supine0703/c51_treg/docs/图 from zyy/说明.txt

本文件内的流程图包含了系统使用流程图，
以及ultimate.c内我认为比较重要的一些方法具体实现的流程图
（按键系统，lcd开机动画，一个页面显示）
