supine0703/c51_treg/docs/图 from yym/主函数.jpg

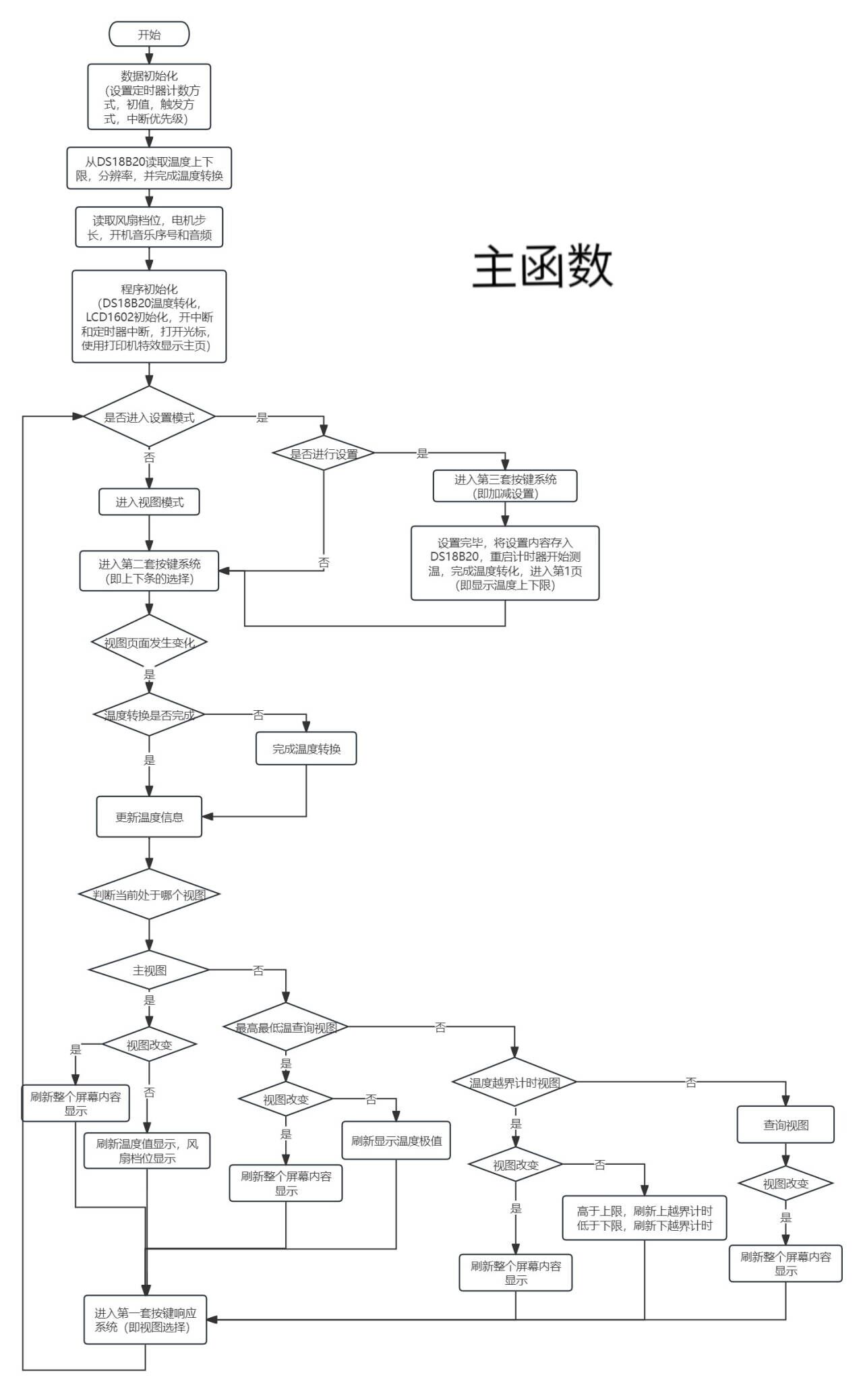
docs/图 from yym/主函数.jpg
