supine0703/c51_treg/docs/图 from zyy/模块依赖图.png

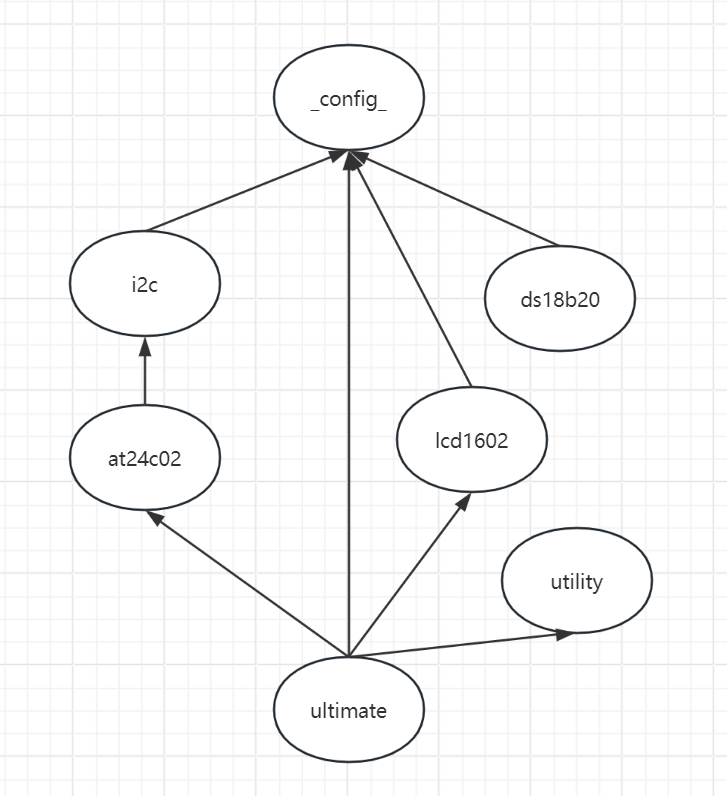
docs/图 from zyy/模块依赖图.png
