supine0703/c51_treg/(list of files, cad)

Other CAD files:
proj/proj_keil5_music/Objects/main.obj
proj/proj_keil5/Objects/main.obj
proj/proj_keil5/Objects/at24c02.obj
proj/proj_keil5/Objects/lcd1602.obj
proj/proj_keil5_music/Objects/music.obj
proj/proj_keil5/Objects/STARTUP.obj
proj/proj_keil5_music/Objects/i2c.obj
proj/proj_keil5/Objects/global.obj
proj/proj_keil5_music/Objects/STARTUP.obj
proj/proj_keil5/Objects/ultimate.obj
proj/proj_keil5_music/Objects/at24c02.obj
proj/proj_keil5/Objects/i2c.obj
proj/proj_keil5/Objects/utility.obj
proj/proj_keil5/Objects/ds18b20.obj
proj/proj_keil5/Objects/__config__.obj
