supine0703/c51_treg/(list of files, drawings)

Other design files:
proj/proj_proteus8.6/Ultimate2.pdsprj
proj/proj_proteus8.6/Ultimate.pdsprj
