supine0703/c51_treg/proj/src/ultimate.c

/**
 * 作者：李宗霖 日期：2023/12/01
 * CSDN昵称：Leisure_水中鱼
 * CSDN: https://blog.csdn.net/Supine_0?type=blog
 * ----------------------------------------------
 */
#include "__config__.h"
#include "at24c02.h"
#include "lcd1602.h"
#include "utility.h"

#define uint unsigned int
#define uchar unsigned char

#define WELCOME "Welcome to AAUCS"
#define _GROUP_ "      NO.13     "
#define SETTING_NUM 6

extern uint SHOW_WAIT;
extern bit page_change;
extern bit ringtone_change;
extern char upperLimit, lowerLimit;
extern float temperature;
extern float highest, lowest;
extern uchar fanGear, fanGearStep;
extern uchar hus, hms, hs, hm; // 开机后 超过温度上限 时间
extern uchar lus, lms, ls, lm; // 开机后 低于温度下限 时间
extern uchar key, pressKey, page, option;
extern uchar dsr, ringtoneNum, ringRate, changeCount;
extern uchar numStr[];
extern uchar code DC[];
extern uchar idata musicArr[];

void Delay1ms(uint t) // 12MHz
{                     // 软件延迟 参数用uchar 比uint 精准
    uchar i;
    while (t--) // mov dec mov jnz orl jz : 9us
    {
        i = 123;    // mov : 1us
        while (i--) // mov dec mov jz : 6us * 124
        {
        } // jmp : 2us * 123
    }     // 每当低位为 0 会多1us处理高位(dec) 忽略
} // (8+1+8*124-2)us * t + ((t/256)+10+6)us 约 t ms

void UpdateExtremes(bit which);

// ============== LCD1602 ==============

void LCD1602_ShowString(uchar* s)
{
    while (*s)
    {
        LCD1602_WriteData(*s++);
        Delay1ms(SHOW_WAIT);
    }
}

void LCD1602_Action(void)
{
    uchar i;
    // 开启 LCD1602 显示 (initial)
    LCD1602_WriteCmd(Set_8bit_2line_5x7);   // 命令6
    LCD1602_WriteCmd(Show_CursorOff);       // 命令4
    LCD1602_WriteCmd(Mode_CursorRightMove); // 命令3
    LCD1602_WriteCmd(Clear_Screen);         // 命令1

    // 开机界面
    LCD1602_WriteCmd(Move_Cursor_Row1_Col(16)); // 命令8 设置光标在显示屏之外
    LCD1602_ShowString(WELCOME);
    SHOW_WAIT = 200;
    LCD1602_WriteCmd(Move_Cursor_Row2_Col(16)); // 命令8
    LCD1602_WriteCmd(Mode_ScreenRightMove);     // 命令3
    LCD1602_ShowString(_GROUP_); // 一边输出第二行 一边移动屏幕
    LCD1602_WriteCmd(Mode_CursorRightMove); // 命令3  恢复光标自增

    i = 3;
    do // 闪烁三次
    {
        LCD1602_WriteCmd(Show_ScreenOff); // 命令4
        Delay1ms(SHOW_WAIT * 2);
        LCD1602_WriteCmd(Show_CursorOff); // 命令4
        Delay1ms(SHOW_WAIT * 2);
    } while (--i);
    i = 16;
    do
    {
        LCD1602_WriteCmd(Shift_ScreenRight); // 命令5
        Delay1ms(SHOW_WAIT);
    } while (--i);                  // 字体移出屏幕
    LCD1602_WriteCmd(Clear_Screen); // 命令1 清屏
    SHOW_WAIT = 0;
} // LCD1602 Action

void ShowViewPage_1(void)
{
    // 第一行 温度上限 温度下限
    LCD1602_WriteCmd(Clear_Screen); // 命令1 清屏
    LCD1602_ShowString("H:");
    Int8ToString(upperLimit, numStr, 3);
    LCD1602_ShowString(numStr);
    LCD1602_ShowString(DC);
    LCD1602_ShowString("  L:");
    Int8ToString(lowerLimit, numStr, 3);
    LCD1602_ShowString(numStr);
    LCD1602_ShowString(DC);
    // 第二行 温度 风扇档位
    LCD1602_WriteCmd(Move_Cursor_Row2_Col(0));
    LCD1602_ShowString("T:");
    FloatToString(temperature, numStr, 5, 1);
    LCD1602_ShowString(numStr);
    LCD1602_ShowString(DC);
    LCD1602_ShowString("  FAN:");
    Int8ToString(fanGear, numStr, 1);
    LCD1602_ShowString(numStr);
}

void ShowViewPage_2(void)
{
    // 第一行 自开机后的最高温
    LCD1602_WriteCmd(Clear_Screen); // 命令1 清屏
    LCD1602_ShowString("Highest: ");
    UpdateExtremes(1);
    // 第二行 自开机后的最低温
    LCD1602_WriteCmd(Move_Cursor_Row2_Col(0));
    LCD1602_ShowString("Lowest:  ");
    UpdateExtremes(0);
}

void ShowViewPage_3(void)
{
    void UpdateOverLimitTimer(bit which);
    // 第一行 超过温度上限时长
    LCD1602_WriteCmd(Clear_Screen); // 命令1 清屏
    LCD1602_ShowString("Above H:");
    UpdateOverLimitTimer(1);
    // 第二行 低于温度下限时长
    LCD1602_WriteCmd(Move_Cursor_Row2_Col(0));
    LCD1602_ShowString("Below L:");
    UpdateOverLimitTimer(0);
}

void ShowViewPage_4(void)
{
    char KeysSystem_3(void);
    uchar i;
    LCD1602_WriteCmd(Clear_Screen); // 命令1 清屏
    // 第一行 温感分辨率 风扇档位步长 (开机音乐?)
    LCD1602_WriteCmd(Clear_Screen); // 命令1 清屏
    LCD1602_ShowString("TR: ");
    LCD1602_WriteData('0' + dsr);
    LCD1602_ShowString("   FGS: ");
    LCD1602_WriteData('0' + fanGearStep);
    LCD1602_ShowString(DC);
    // 第二行 ring速度
    LCD1602_WriteCmd(Move_Cursor_Row2_Col(0));
    LCD1602_ShowString("ringRate:");
    i = 0;
    while (i < ringRate)
    {
        LCD1602_WriteData(0xff);
        ++i;
    }
}

void ShowSettings(uchar opt)
{
    bit i;
    uchar sgl[2][2] = {{0x7e, 0x7f}, {' ', ' '}};
    if (opt == option)
        return;
    if ((opt >> 1) != (option >> 1))
    {
        LCD1602_WriteCmd(Clear_Screen); // 命令1 清屏
        switch (opt >> 1)
        {
        case 0: {
            // 0 温度上限
            LCD1602_WriteCmd(Move_Cursor_Row1_Col(1));
            LCD1602_ShowString("H Limit: ");
            Int8ToString(upperLimit, numStr, 3);
            LCD1602_ShowString(numStr);
            LCD1602_ShowString(DC);
            // 1 温度下限
            LCD1602_WriteCmd(Move_Cursor_Row2_Col(1));
            LCD1602_ShowString("L Limit: ");
            Int8ToString(lowerLimit, numStr, 3);
            LCD1602_ShowString(numStr);
            LCD1602_ShowString(DC);
            break;
        }
        case 1: {
            // 2 温感分辨率
            LCD1602_WriteCmd(Move_Cursor_Row1_Col(1));
            LCD1602_ShowString("TResolution: ");
            LCD1602_WriteData('0' + dsr);
            // 3 风扇档位步长
            LCD1602_WriteCmd(Move_Cursor_Row2_Col(1));
            LCD1602_ShowString("FGear' Step: ");
            LCD1602_WriteData('0' + fanGearStep);
            break;
        }
        case 2: {
            // 4 开机铃声
            LCD1602_WriteCmd(Move_Cursor_Row1_Col(2));
            LCD1602_ShowString("ringtone:  ");
            LCD1602_WriteData('0' + ringtoneNum);
            // 5 音量
            LCD1602_WriteCmd(Move_Cursor_Row2_Col(2));
            LCD1602_ShowString("ring Rate: ");
            LCD1602_WriteData('0' + ringRate);
            break;
        }
        }
    }
    i = opt & 1;
    LCD1602_WriteCmd(Move_Cursor_Row1_Col(0));
    LCD1602_WriteData(sgl[i][0]);
    LCD1602_WriteCmd(Move_Cursor_Row1_Col(15));
    LCD1602_WriteData(sgl[i][1]);
    i = !i;
    LCD1602_WriteCmd(Move_Cursor_Row2_Col(0));
    LCD1602_WriteData(sgl[i][0]);
    LCD1602_WriteCmd(Move_Cursor_Row2_Col(15));
    LCD1602_WriteData(sgl[i][1]);
    option = opt;
}

void ChangeSetting(void)
{
    char i, j;
    uchar cunt = 24;
    bit flag = 0;
    switch (option)
    {
    case 0: {
    } // 这一段差异性和共性都多，为了节约一点内存，三目运算符 时间换空间
    case 1: { // 这一段逻辑复杂，只用知道是增加/减少上限下限的
        i = option ? lowerLimit : upperLimit;
        while (1)
        {
            if (!--cunt)
            {
                cunt = 24;
                flag = !flag;
            }
            LCD1602_WriteCmd((option ? 0xc0 : 0x80) | 10);
            if (flag)
                LCD1602_ShowString("   ");
            else
            {
                Int8ToString(i, numStr, 3);
                LCD1602_ShowString(numStr);
            }
            switch (KeysSystem_3())
            {
            case 2: {
                if (option)
                    lowerLimit = i;
                else
                    upperLimit = i;
            }
            case -2: { // 可能会因为时序造成空白 所以要
                LCD1602_WriteCmd((option ? 0xc0 : 0x80) | 10);
                Int8ToString(option ? lowerLimit : upperLimit, numStr, 3);
                LCD1602_ShowString(numStr); // 刷新一下数据
                return;
            }
            case -1: {
                if (i > -55 && ((i > lowerLimit + 1) || option))
                    --i;
                break;
            }
            case 1: {
                if (i < 127 && ((i < upperLimit - 1) || !option))
                    ++i;
                break;
            }
            }
        }
    }
    case 5: {
        i = ringRate; // 0 - 7
    }
    case 4: {
        if (option == 4)
            i = ringtoneNum; // 0 - 3
    }
    case 3: {
        if (option == 3)
            i = fanGearStep; // 0 - 7
    }
    case 2: { // 这一部分代码几乎一样，就复用了用来增大/减小选项值
        if (option == 2)
            i = dsr; // 0 - 3
        LCD1602_WriteCmd(
            (option & 1 ? 0xc0 : 0x80) |
            ((option == 5 || option == 4) ? 14 : 15)
        );
        while (1)
        {
            if (!--cunt)
            {
                cunt = 24;
                flag = !flag;
            }
            if (flag)
                j = ' ';
            else
                j = '0' + i;
            LCD1602_WriteCmd(Shift_CursorLeft);
            LCD1602_WriteData(j);
            switch (KeysSystem_3())
            {
            case 2: {
                if (option == 5)
                    ringRate = i;
                else if (option == 4 && ringtoneNum != i)
                {
                    ringtone_change = 1;
                    ringtoneNum = i;
                }
                else if (option == 3)
                    fanGearStep = i;
                else if (option == 2)
                    dsr = i;
            }
            case -2: {
                j = option == 5
                        ? ringRate
                        : (option == 4 ? ringtoneNum
                                       : (option == 3 ? fanGearStep : dsr));
                LCD1602_WriteCmd(Shift_CursorLeft);
                LCD1602_WriteData(j + '0');
                return;
            }
            case -1: {
                if (i > 0)
                    --i;
                break;
            }
            case 1: {
                if (i < 3 + ((option == 3 || option == 5) ? 4 : 0))
                    ++i;
                break;
            }
            }
        }
    }
    }
}

// -------------------------------------

bit CheckKeysInvalid()
{
    uchar old = key;
    Delay1ms(10);
    key = 0x0f;
    key |= KEYS;
    return key != old;
}

void KeysSystem_1(void)
{
    KEYS = 0xff;
    key = 0x0f; // 排除 P33 P32 P31 P30
    key |= KEYS;
    switch (key)
    {
    case 0x7f: // P37
    case 0xbf: // P36
    case 0xdf: // P35
    case 0xef: // P34
        if (page == key || CheckKeysInvalid())
            return;
        pressKey = key;
        break;
    case 0xff: // 松开 上升沿触发
        if (pressKey == 0xff || CheckKeysInvalid())
            return;
        page_change = 1;
        page = pressKey;
    default:
        pressKey = 0xff;
    }
}

void KeysSystem_2(void)
{
    uchar opt;
    KEYS = 0xff;
    key = 0x0f; // 排除 P33 P32 P31 P30
    key |= KEYS;
    switch (key)
    {
    case 0x7f: // P37
    case 0xbf: // P36
    case 0xdf: // P35
    case 0xef: // P34
        if (CheckKeysInvalid())
            return;
        pressKey = key;
        break;
    case 0xff: // 松开 上升沿触发
        if (pressKey == 0xff || CheckKeysInvalid())
            return;
        // 执行按键功能
        switch (pressKey)
        {
        case 0x7f: { // P37 进入设置
            EA = 0;
            pressKey = 0xff;
            ChangeSetting();
            pressKey = 0xff;
            EA = 1;
            return;
        }
        case 0xbf: { // P36 下一条
            opt = option + 1;
            if (opt == SETTING_NUM)
                opt = 0;
            break;
        }
        case 0xdf: { // P35 上一条
            if (!option)
                opt = SETTING_NUM - 1;
            else
                opt = option - 1;
            break;
        }
        case 0xef: { // P34 首条
            opt = 0;
        }
        }
        ShowSettings(opt);
    default:
        pressKey = 0xff;
    }
}

char KeysSystem_3(void)
{
    KEYS = 0xff;
    key = 0x0f; // 排除 P33 P32 P31 P30
    key |= KEYS;
    if (CheckKeysInvalid())
        return 0; // 为了稳定的时序，所以在这里消抖
    switch (key)
    {
    // 低电平触发，长按加快变化
    case 0xbf: // P36 增加
    case 0xdf: // P35 减少
        if (pressKey == key)
        {
            if (!changeCount)
            {
                ++changeCount;
                return key == 0xbf ? 1 : -1;
            }
            if ((++changeCount >= 0x60) && !(changeCount & 0x0f))
                return key == 0xbf ? 1 : -1;
            if (changeCount == 0xff)
                changeCount = 0x5f;
            return 0;
        }
        else
        {
            changeCount = 0;
        }
    // 上升沿触发
    case 0x7f: // P37 取消
    case 0xef: // P34 确定
        pressKey = key;
        break;
    case 0xff: // 松开 上升沿触发
        if (pressKey == 0xff)
            return 0;
        // 执行按键功能
        switch (pressKey)
        {
        case 0x7f: { // P37 取消
            pressKey = 0xff;
            return -2;
        }
        case 0xef: { // P34 确定
            pressKey = 0xff;
            return 2;
        }
        }
    default:
        pressKey = 0xff;
    }
    return 0;
}

void AboveLimitClock(void)
{
    if (++hus == 180)
    {
        hus = 0;
        if (++hms == 20)
        {
            hms = 0;
            if (++hs == 60)
            {
                hs = 0;
                if (++hm == 60)
                {
                    hm = 0;
                }
            }
        }
    }
}

void BelowLimitClock(void)
{
    if (++lus == 180)
    {
        lus = 0;
        if (++lms == 20)
        {
            lms = 0;
            if (++ls == 60)
            {
                ls = 0;
                if (++lm == 60)
                {
                    lm = 0;
                }
            }
        }
    }
}

void UpdateOverLimitTimer(bit which) // 1: Above  0: Below
{
    if (which)
    {
        Int8ToString(hm, numStr, 2);
        Int8ToString(hs, numStr + 3, 2);
    }
    else
    {
        Int8ToString(lm, numStr, 2);
        Int8ToString(ls, numStr + 3, 2);
    }
    LCD1602_ShowString(numStr);
    LCD1602_ShowString("m");
    LCD1602_ShowString(numStr + 3);
    LCD1602_ShowString(".");
    if (which)
        Int8ToString(hms >> 1, numStr, 1);
    else
        Int8ToString(lms >> 1, numStr, 1);
    LCD1602_ShowString(numStr);
    LCD1602_ShowString("s");
}

void UpdateExtremes(bit which) // 1: Highest  0: Lowest
{
    FloatToString(which ? highest : lowest, numStr, 5, 1);
    LCD1602_ShowString(numStr);
    LCD1602_ShowString(DC);
}

void ReadMusic(void)
{
    uchar startAddr, musicLen;
    At24c02_ReadData(0xa0, ringtoneNum + 0x03, &startAddr, 1);
    At24c02_ReadData(0xa0, ringtoneNum + 0x04, &musicLen, 1);
    musicLen -= startAddr;
    At24c02_ReadData(0xa0, startAddr, musicArr, musicLen);
}
