supine0703/c51_treg/proj/src/at24c02.c

/**
 * 作者：李宗霖 日期：2023/12/04
 * CSDN昵称：Leisure_水中鱼
 * CSDN: https://blog.csdn.net/Supine_0?type=blog
 * ----------------------------------------------
 * 注意: 24c02的操作是基于I2C操作的 所以对其为强依赖 'i2c.h'
 */
#include "i2c.h"

#define AT24C02_NO_MULTI_PAGE_WRITE

#ifndef uchar
#define uchar unsigned char
#endif

#define PAGE_BIT 4
#define PAGE_END 0x0f

#define PAGE_BYTE 0x10 // 也缓冲器字节数

// 连续读时序
bit At24c02_ReadData(uchar sla, uchar suba, uchar* dat, uchar num)
{
    bit flg;
    uchar i;
    if (!num)
        return 1;
    I2C_Start();       // 启动I2C总线
    I2C_SendByte(sla); // 发送器件地址码
    if (flg = I2C_CheckAck())
    {
        I2C_SendByte(suba); // 发送期间单元地址
        if (flg = I2C_CheckAck())
        {
            I2C_Start();           // 重新启动I2C总线
            I2C_SendByte(sla + 1); // 发送写器件地址码信号
            if (flg = I2C_CheckAck())
            {
                for (i = num - 1; i; --i)
                {
                    *dat = I2C_RecByte();
                    I2C_Ack();
                    ++dat;
                }
                *dat = I2C_RecByte();
                I2C_NoAck();
            }
        }
    }
    I2C_Stop();
    return flg;
}

// 页写入时序 最多为 页写缓冲器的大小 字节 超出会被循环覆盖 且此函数不带延迟
bit At24c02_WriteByte(uchar sla, uchar suba, uchar* dat, uchar num)
{
    bit flg;
    uchar i;
    if (!num)
        return 1;
    I2C_Start();       // 启动I2C总线
    I2C_SendByte(sla); // 发送器件地址码
    if (flg = I2C_CheckAck())
    {
        I2C_SendByte(suba); // 发送期间单元地址
        if (flg = I2C_CheckAck())
        {
            for (i = num; i; --i)
            {
                I2C_SendByte(*dat);
                if (!(flg = I2C_CheckAck()))
                    break; // 无应答
                ++dat;
            }
        }
    }
    I2C_Stop(); // 发送结束信号
    return flg;
}

#ifndef AT24C02_NO_MULTI_PAGE_WRITE

void At24c02_Wait(void) // 12MHz 1000us
{
    uchar t = 164;
    while (t--)
        ;
    for (t = 2; t; --t)
        ;
}

bit At24c02_Check(uchar sla) // 检查是否写入完成
{
    uchar i = 16;
    do // 每毫秒检测一次如果 16 次未应答则是为错误
    {
        At24c02_Wait();
        I2C_Start();
        I2C_SendByte(sla); // 发送器件地址码
    } while (!I2C_CheckAck() && --i);
    I2C_Stop();
    return (i != 0);
}

// 连续页写入 带延迟(确保写入完成)
bit At24c02_WriteData(uchar sla, uchar suba, uchar* dat, uchar num)
{
    uchar begin, end, i;
    if (!num)
        return 1;
    begin = suba >> PAGE_BIT;
    end = (suba + (num - 1)) >> PAGE_BIT;
    if (begin != end)
    {
        i = PAGE_END - (suba & PAGE_END) + 1;
        At24c02_WriteByte(sla, suba, dat, i);
        suba += i;
        dat += i;
        ++begin;
        if (!At24c02_Check(sla))
            return 0;
    }
    while ((begin != end) && begin < PAGE_END)
    {
        At24c02_WriteByte(sla, suba, dat, PAGE_BYTE);
        suba += PAGE_BYTE;
        dat += PAGE_BYTE;
        ++begin;
        if (!At24c02_Check(sla))
            return 0;
    }
    if (At24c02_WriteByte(
            sla,
            suba,
            dat,
            ((begin == end) ? ((num - i) & PAGE_END) : (PAGE_END))
        ))
        return At24c02_Check(sla);
    else
        return 0;
}

#endif

/**
 * 2023/12/04
 * 最开始学24c02我以为页写入操作是存储空间被例如 划分为了 每页16byte 共16page
 * 我以为是只能以每页为单位进行存储 例如 0x03 开始存储到0x0f会自动返回到0x00
 * 实际上是一次最多连续写入16byte 下面有我实现的 '错误' 的连续页写入方式
实现方法很有参考价值
 * 故此保留 参见24c02的数据手册可知 需要页写入时因为受限于 页写缓冲器的大小

 * 2023/12/05
 * 之前又错了 我最开始的理解没错 24c02内存就是被分为了多页 每次写入无法自动翻页
 * 我之前理解错误 参见24c02的数据手册:'内存地址低位加1 高位不变'
就是我之前理解的
 * 所以我将重新启用之前的算法 将错误的算法放在下方以作参考



bit At24c02_WriteData(uchar sla, uchar suba, uchar* dat, uchar num)
{
    while (num > PAGE_BYTE) // 按页写入数据 并且等待写入成功开始下一页写入
    {
        if (!At24c02_WriteByte(sla, suba, dat, PAGE_BYTE))
            return 0;
        suba += PAGE_BYTE;
        dat += PAGE_BYTE;
        num -= PAGE_BYTE;
        if (!At24c02_Check(sla))
            return 0;
    }
    if (At24c02_WriteByte(sla, suba, dat, num))
        return At24c02_Check(sla);
    else
        return 0;
}

*/
