supine0703/c51_treg/(commit log)

2023-11-28 基本功能
    代码部分，基本完成lcd1602的封装，迭代+1（较为完善）；ds18b20的封装基本完成，目前比较混乱，待迭代；主函数实现开机、温度显示、写入温度上限下限，读取。
    proteus部分，目前完成：时序电路11.0592；复位电路；lcd1602电路；按键电路；ds18b20电路；流水灯电路。
    TODO:
    proteus：步进电机电路；数码管电路；dac0832电路；蜂鸣器电路。todo... ...
    keil5: dac0832封装--存储音乐+蜂鸣器使用；步进电机代码设计；按键功能模块设计。todo... ...
    [STARTUP.obj, Ultimste.pdsprj, __config__.obj, ds18b20.obj, lcd1602.obj, lr.obj, main.obj, ultimste.obj]
2023-11-30 暂告一段落
    按键系统基本实现
    视图页面/设置页面/设置模式
    今天太累了，更详细的之后再补充
    [STARTUP.obj, Ultimate.pdsprj, Ultimste.pdsprj, __config__.obj, ds18b20.obj, global.obj, lcd1602.obj, lr.obj]
2023-12-02 基本完成了要求的功能
    TODO 待加入24LC02所有功能就完成了 应该?
    [STARTUP.obj, Ultimate.pdsprj, __config__.obj, ds18b20.obj, global.obj, lcd1602.obj, main.obj, ultimate.obj]
2023-12-02 优化了bug
    更改了
    1. 直流电机驱动和继电器驱动写反了的问题
    2. 按键系统3 长按持续加减的卡顿问题
    优化开机界面滑动太快导致显示不清问题
    [STARTUP.obj, __config__.obj, ds18b20.obj, global.obj, lcd1602.obj, main.obj, ultimate.obj, utility.obj]
2023-12-02 通过硬件测试，没有问题的版本
    给ds18b20_save添加了延迟，修改了部分变量的初值
    [STARTUP.obj, __config__.obj, ds18b20.obj, global.obj, lcd1602.obj, main.obj, ultimate.obj, utility.obj]
2023-12-03 封装了I2C 优化了计时
    将I2C相关函数进行封装，已经验证无误
    对于关闭中断那，之前算出的不够精确，现在已优化 误差在5个机器周期内
    [STARTUP.obj, Ultimate.pdsprj, __config__.obj, ds18b20.obj, global.obj, i2c.obj, lcd1602.obj, main.obj]
2023-12-04 重构了config i2c 封装了at89c52 更新了注释
    [STARTUP.obj, Ultimate.pdsprj, at24c02.obj, ds18b20.obj, global.obj, i2c.obj, lcd1602.obj, main.obj]
2023-12-06 几乎是最终版本了
    [STARTUP.obj, Ultimate.pdsprj, Ultimate2.pdsprj, at24c02.obj, ds18b20.obj, global.obj, i2c.obj, lcd1602.obj]
2023-12-06 此版本通过了硬件测试
    [STARTUP.obj, Ultimate.pdsprj, at24c02.obj, ds18b20.obj, global.obj, i2c.obj, lcd1602.obj, main.obj]
2023-12-06 Create 周妍妍
2023-12-08 更新 README LICENSE 整理
    [STARTUP.obj, at24c02.obj, ds18b20.obj, global.obj, i2c.obj, lcd1602.obj, main.obj, ultimate.obj]
2023-12-08 更新 README
    顺便解决了进入设置模式风扇仍然转动问题
    [STARTUP.obj, at24c02.obj, ds18b20.obj, global.obj, i2c.obj, lcd1602.obj, main.obj, ultimate.obj]
